klaasnicolaas/Spot-Redux/STL_files/side_chassis_right_v1.stl

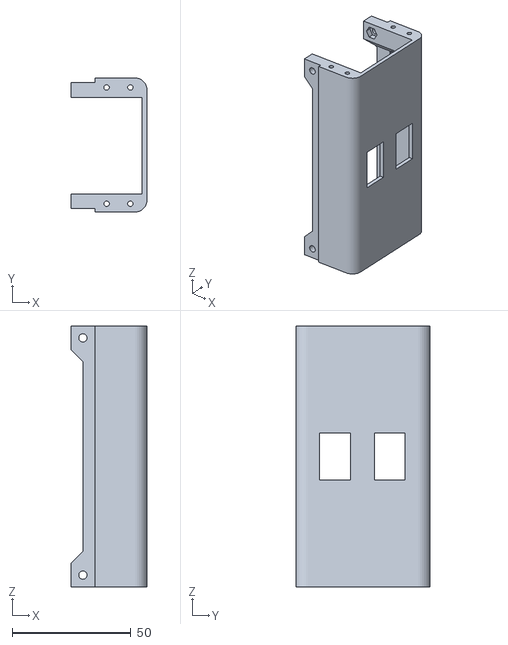
[picture p2: CAD file, 2022-01-28]
STL_files/side_chassis_right_v1.stl
32.0 x 56.5 x 110.0
