klaasnicolaas/Spot-Redux/STL_files/romp_endcap_v3.stl

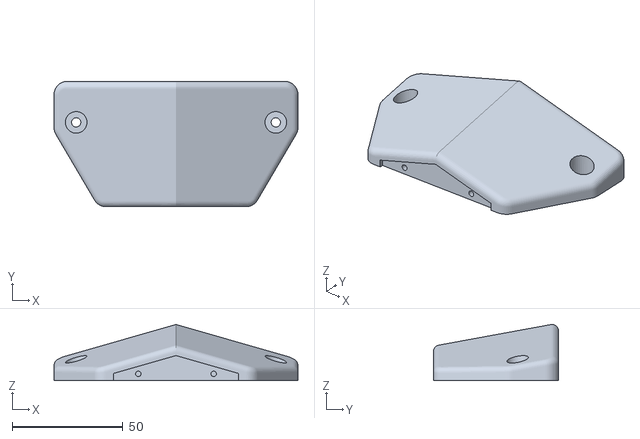
[picture p3: CAD file, 2022-01-28]
STL_files/romp_endcap_v3.stl
110.0 x 56.5 x 25.3
