klaasnicolaas/Spot-Redux/STL_files/servo_arm_mod_right_v3.stl

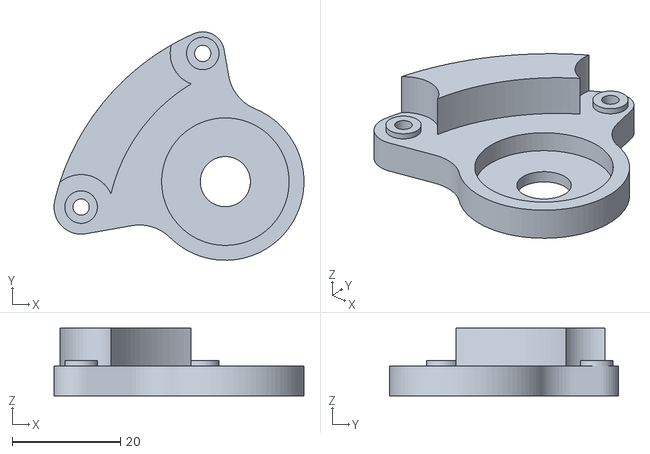
[picture p4: CAD file, 2022-01-28]
STL_files/servo_arm_mod_right_v3.stl
46.1 x 42.1 x 12.5
