klaasnicolaas/Spot-Redux/STL_files/servo_arm_mod_ring_v3.stl

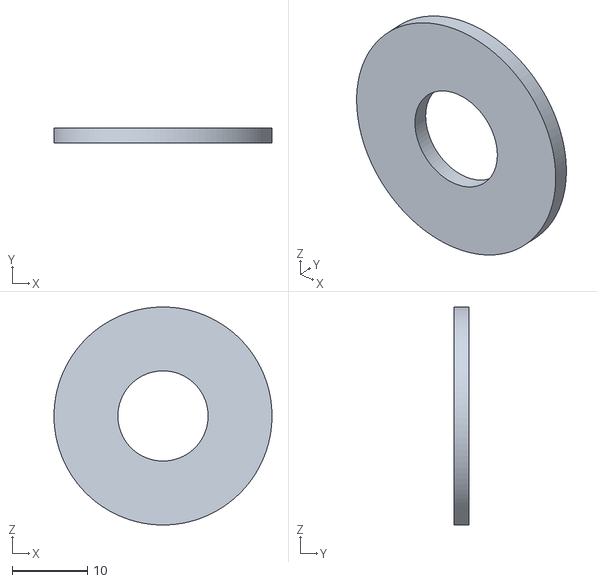
[picture p5: CAD file, 2022-01-28]
STL_files/servo_arm_mod_ring_v3.stl
29.0 x 2.00 x 29.0
