klaasnicolaas/Spot-Redux/STL_files/femur_v3.stl

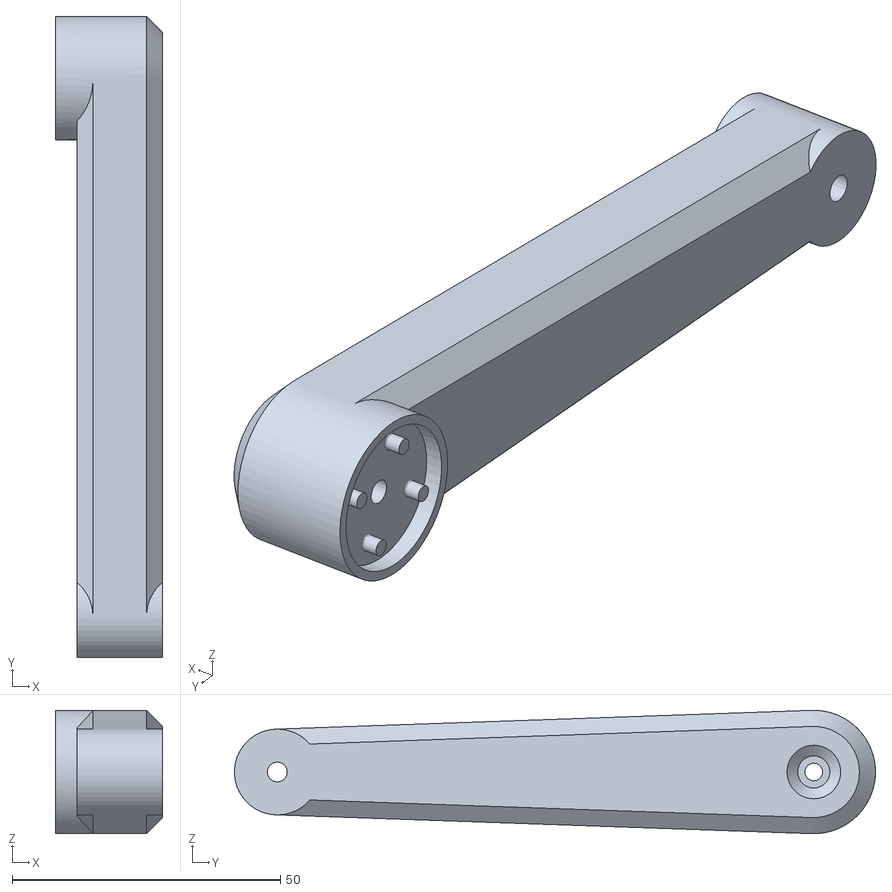
[picture p6: CAD file, 2022-01-28]
STL_files/femur_v3.stl
20.0 x 119.5 x 23.0
