klaasnicolaas/Spot-Redux/STL_files/servo_arm_mod_bow_left_v3.stl

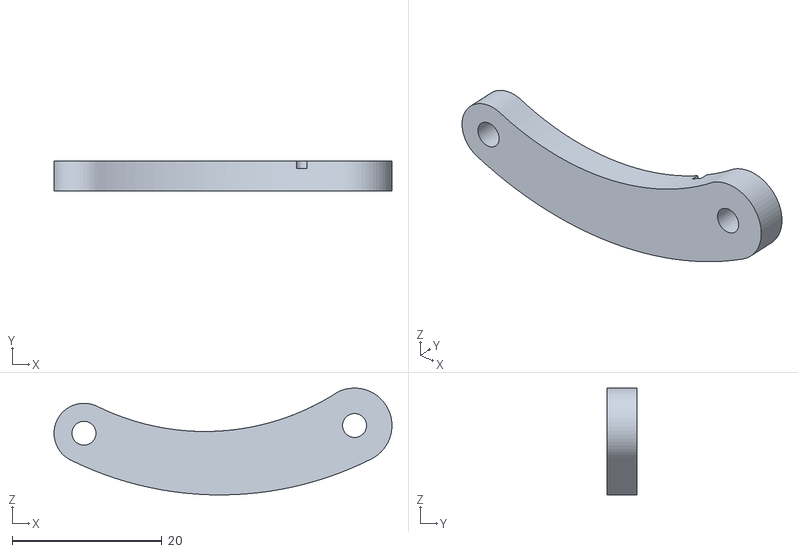
[picture p7: CAD file, 2022-01-28]
STL_files/servo_arm_mod_bow_left_v3.stl
45.1 x 4.00 x 14.3
