klaasnicolaas/Spot-Redux/STL_files/shoulder_holder_right_outer_v6.stl

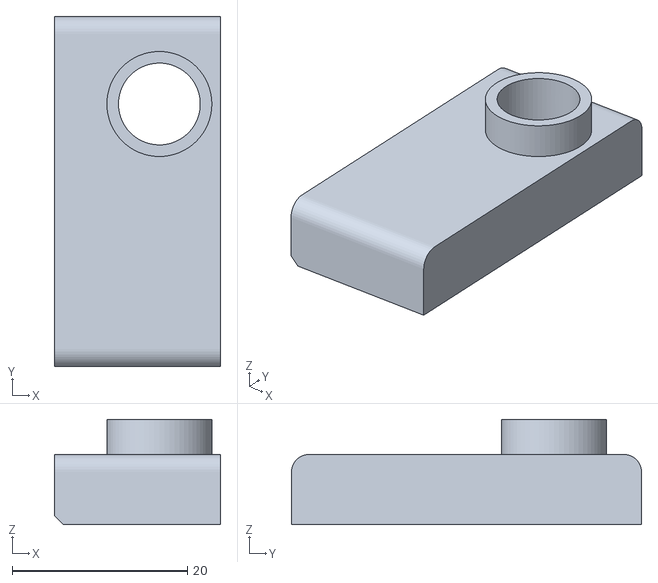
[picture p8: CAD file, 2022-01-28]
STL_files/shoulder_holder_right_outer_v6.stl
19.0 x 40.0 x 12.0
