klaasnicolaas/Spot-Redux/STL_files/foot_v3.stl

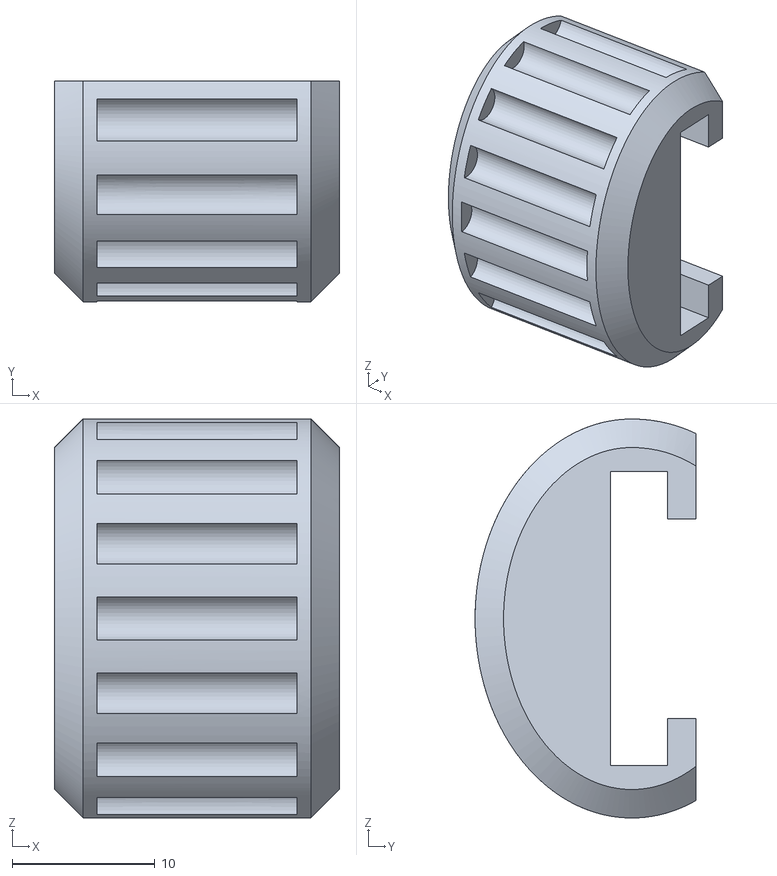
[picture p9: CAD file, 2022-01-20]
STL_files/foot_v3.stl
20.0 x 15.5 x 28.0
