klaasnicolaas/Spot-Redux/STL_files/shoulder holder right inner v4.stl

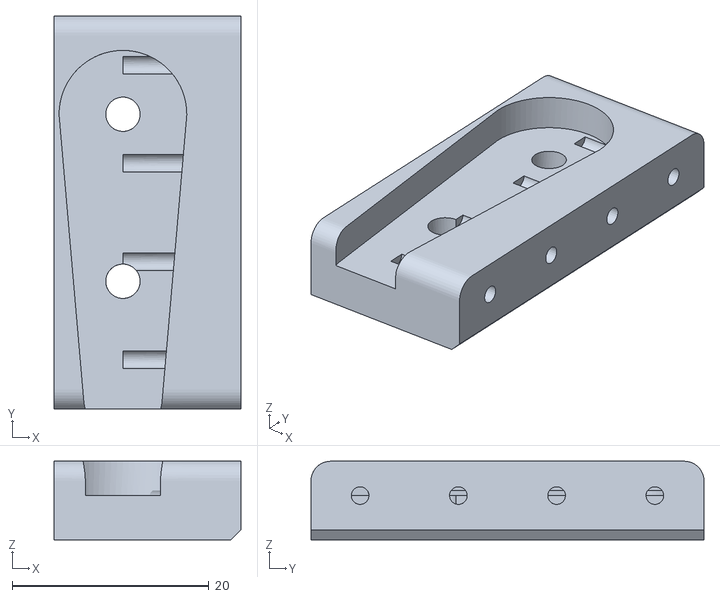
[picture p10: CAD file, 2022-01-20]
STL_files/shoulder holder right inner v4.stl
19.0 x 40.0 x 8.00
