klaasnicolaas/Spot-Redux/STL_files/tibia_right_2_v2.stl

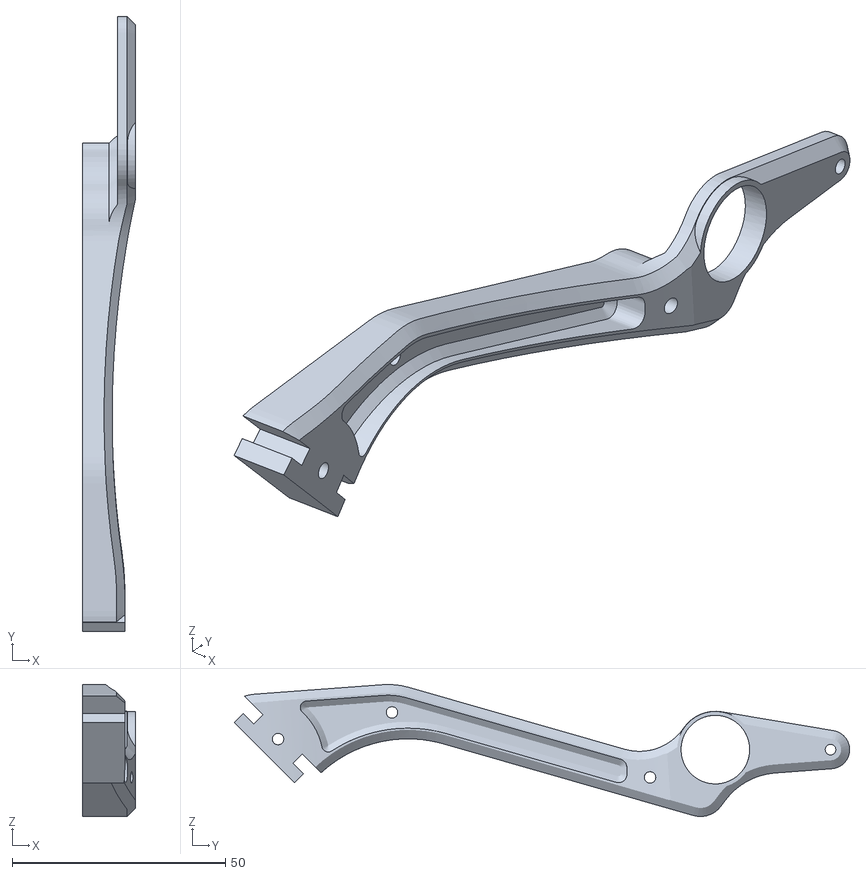
[picture p11: CAD file, 2022-01-20]
STL_files/tibia_right_2_v2.stl
12.5 x 144.3 x 30.9
