klaasnicolaas/Spot-Redux/STL_files/tibia_right_1_v2.stl

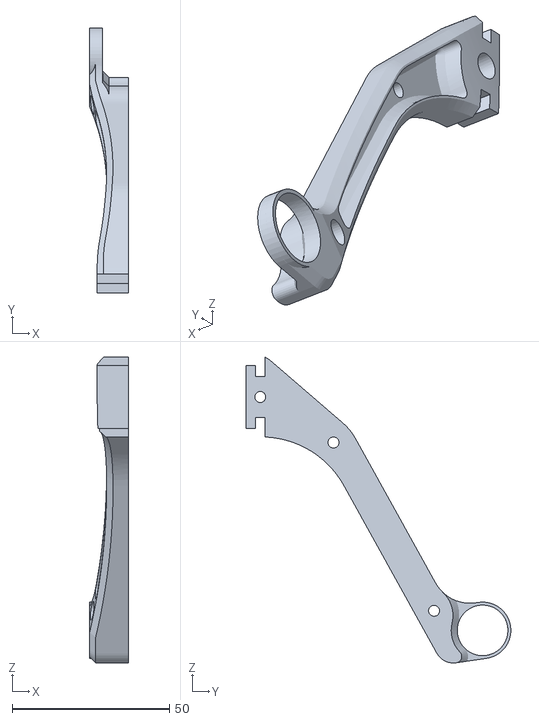
[picture p12: CAD file, 2022-01-20]
STL_files/tibia_right_1_v2.stl
12.5 x 84.2 x 97.4
