klaasnicolaas/Spot-Redux/STL_files/tibia_left_2_v2.stl

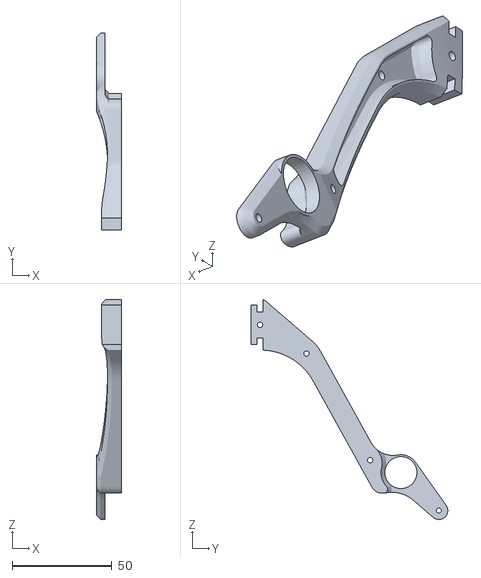
[picture p13: CAD file, 2022-01-20]
STL_files/tibia_left_2_v2.stl
12.5 x 98.8 x 110.6
