klaasnicolaas/Spot-Redux/(list of files, cad)

Other CAD files:
STL_files/side_chassis_left_v1.stl
STL_files/servo_arm_mod_left_v3.stl
STL_files/shoulder_holder_left_outer_v6.stl
STL_files/servo_arm_mod_bow_right_v3.stl
STL_files/shoulder holder left inner v4.stl
STL_files/tibia_left_1_v2.stl
STL_files/OLD VERSIONS/28mm rod v1.stl
STL_files/OLD VERSIONS/pca9685 mod box.stl
STL_files/OLD VERSIONS/romp endcap.stl
STL_files/OLD VERSIONS/servo spacer.stl
STL_files/OLD VERSIONS/servo_spacer_v2.stl
STL_files/OLD VERSIONS/servo_spacer_v3.stl
STL_files/OLD VERSIONS/shoulder holder left inner v2.stl
STL_files/OLD VERSIONS/shoulder holder left inner v3.stl
STL_files/OLD VERSIONS/shoulder holder left inner.stl
STL_files/OLD VERSIONS/shoulder holder left outer v2.stl
STL_files/OLD VERSIONS/shoulder holder left outer v3.stl
STL_files/OLD VERSIONS/shoulder holder left outer v4.stl
STL_files/OLD VERSIONS/shoulder holder left outer.stl
STL_files/OLD VERSIONS/shoulder holder right inner v2.stl
STL_files/OLD VERSIONS/shoulder holder right inner v3.stl
STL_files/OLD VERSIONS/shoulder holder right inner.stl
STL_files/OLD VERSIONS/shoulder holder right outer v2.stl
STL_files/OLD VERSIONS/shoulder holder right outer v3.stl
STL_files/OLD VERSIONS/shoulder holder right outer v4.stl
STL_files/OLD VERSIONS/shoulder holder right outer.stl
