klaasnicolaas/Spot-Redux/STL_files/plates_v2_drawing.pdf

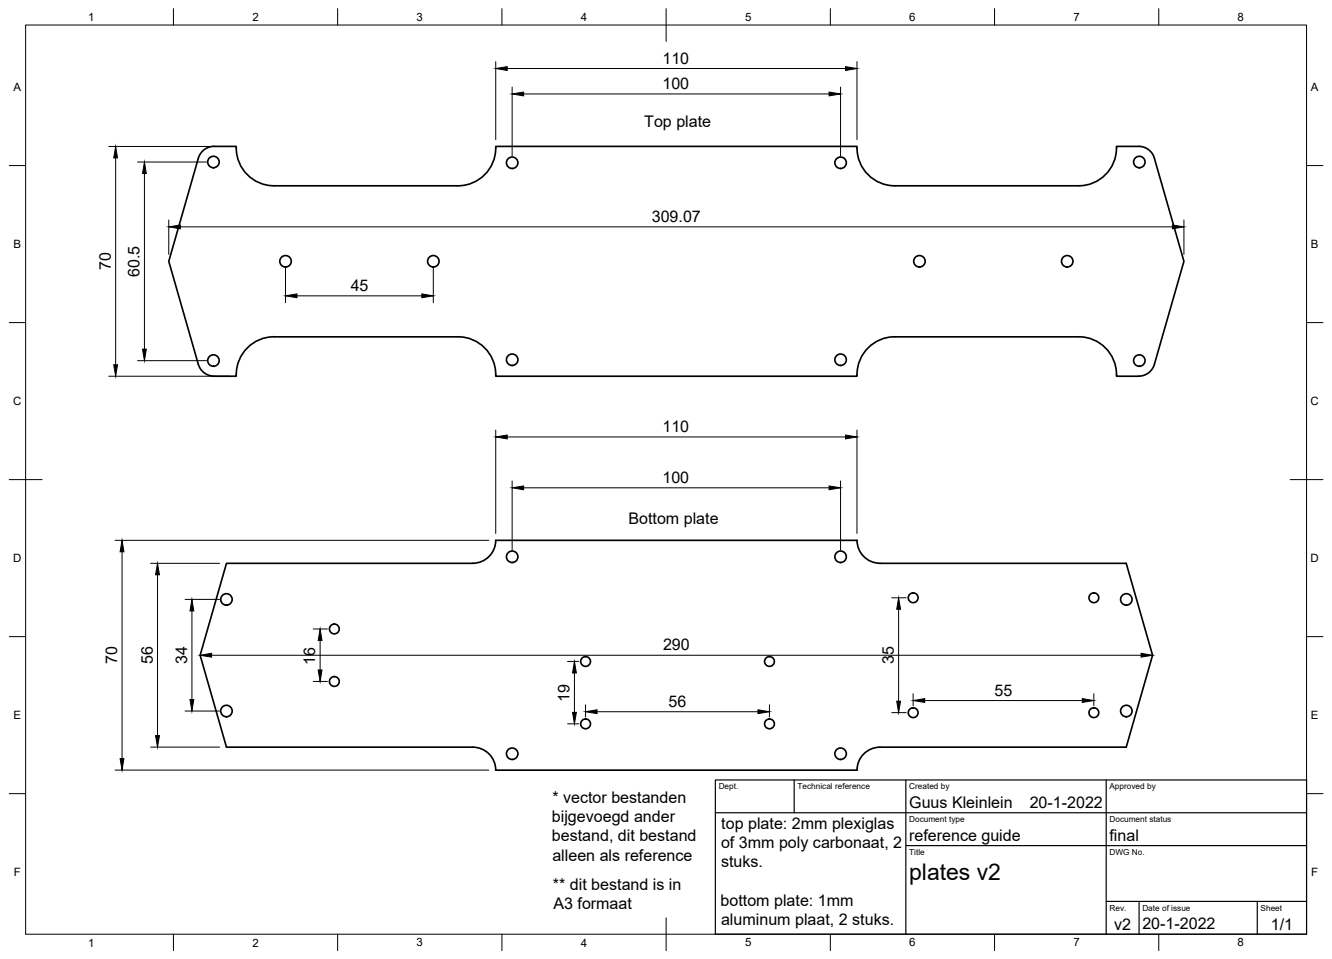
[picture p14: page 1]
Title; DWG No.; Rev.; Date of issue; Sheet; plates v2; Top plate; Bottom plate

Dept. | Technical reference | Created by Guus Kleinlein 20-1-2022 | Approved by

* vector bestanden
bijgevoegd ander
bestand, dit bestand
alleen als reference

top plate: 2mm plexiglas
of 3mm poly carbonaat, 2
stuks.

Document type reference guide | Document status final

** dit bestand is in
A3 formaat

bottom plate: 1mm
aluminum plaat, 2 stuks.
