klaasnicolaas/Spot-Redux/(commit log)

2021-12-06 added: esp32 inverse kinametics source code
2021-12-07 Fix: missing import and function call
    [inverse_kinametics.py]
2021-12-07 Update - python files and add documentation (#2)
    * Edit: servo default start position
    * 📚 Init on readme documentation
    * Add: requirements file for venv
    * Edit: python test script
    * add: gitignore file
2021-12-14 Inplement - Inverse Kinamatics (#3)
    * 🚑 Fix issue on Z as
    * Add boundry for range test loops
    * Inplement use of Inverse Kinamatics
    [default.py, inverse_kinametics.py, test.py]
2022-01-20 -Added most current stl models of the robot (#5)
    [28mm rod v1.stl, femur v3.stl, foot v3.stl, pca9685 mod box v2.stl, pca9685 mod box.stl, romp endcap v2.stl, romp endcap.stl, servo mod extra support v1.stl]
2022-01-28 Add quadruped code (#6)
    * 🚚 Move files to new folder
    * Add some extra documentation
    * 📚 Update documentation
    * 🎨 Change youtube video load
    * 🎨 Change height and width
    * 📚 Add demo info
    * ✨ Add code base from own fork
    [kaoffs.cfg, kastep.cfg, smgyro.cfg, smoffs.cfg, smstep.cfg]
2022-01-28 Add latest versions of printed files (#7)
    * Update the list of 3d printed parts
    * 📚 Add small glossary
    [28mm rod v1.stl, femur v3.stl, femur_v3.stl, foot_v3.stl, pca9685 mod box.stl, pca9685_mod_box_v2.stl, romp endcap v2.stl, romp endcap.stl]
2022-01-28 📚 Update demo videos
2022-01-31 Fix: removed old files, fixed naming convention, added source CAD (#8)
    * -fix: removed old files, fixed naming convention, added source CAD
    * :pencil2: Tweak
    * Revert ":pencil2: Tweak"
    This reverts commit 81419a3fb9a1fae1a89b5494b655e5150b435b54.
    * Rename step file
    [pca9685_mod_box_v2.stl, servo_arm_mod_bow_left_v3.stl, servo_arm_mod_bow_right_v3.stl, servo_arm_mod_left_v3.stl, servo_arm_mod_right_v3.stl, servo_arm_mod_ring_v3.stl, servo_arm_mod_v3_bow_left.stl, servo_arm_mod_v3_bow_right.stl]
